AndrejRii/FireFighterCar/Documentation/Pictures/IMG_20231127_212735.jpg

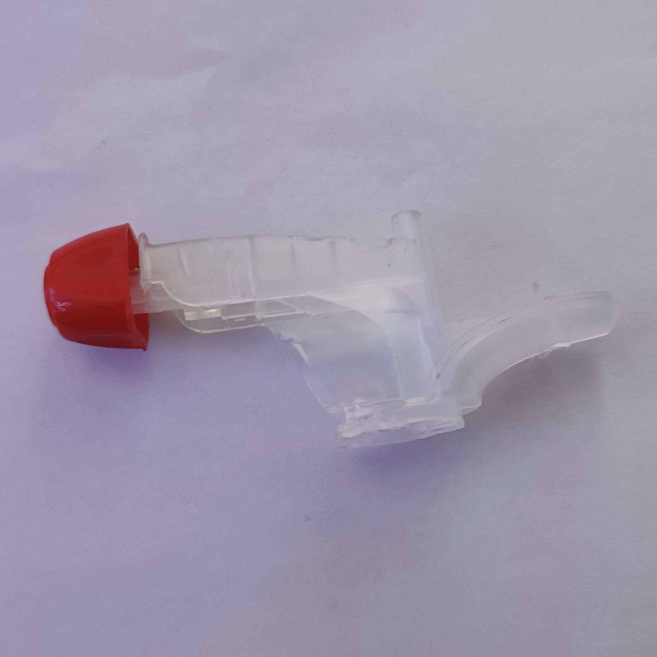
Documentation/Pictures/IMG_20231127_212735.jpg
