AndrejRii/FireFighterCar/Documentation/Pictures/IMG_20231127_210846.jpg

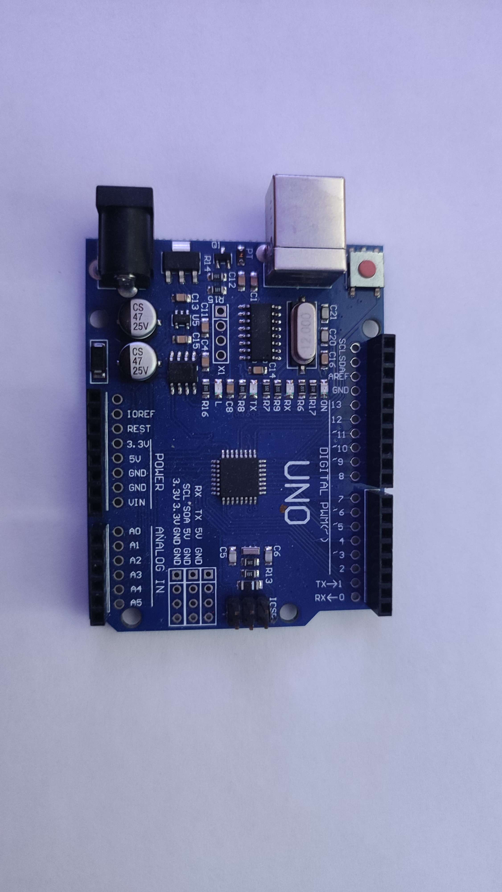
Documentation/Pictures/IMG_20231127_210846.jpg
