AndrejRii/FireFighterCar/Documentation/Pictures/IMG_20231127_210959.jpg

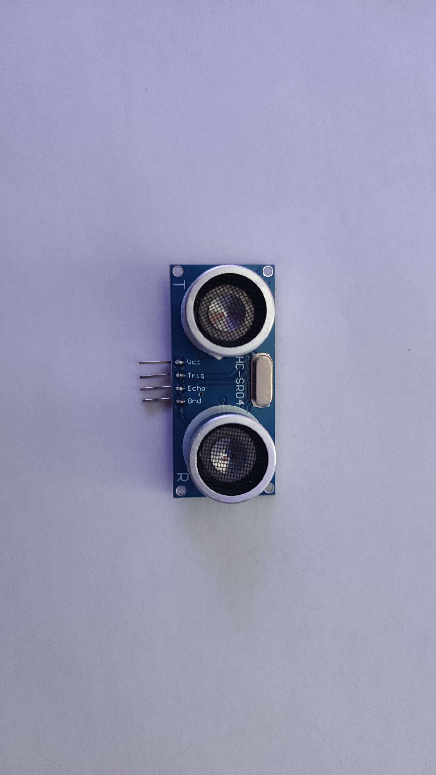
Documentation/Pictures/IMG_20231127_210959.jpg
