AndrejRii/FireFighterCar/Documentation/Pictures/IMG_20231127_212211.jpg

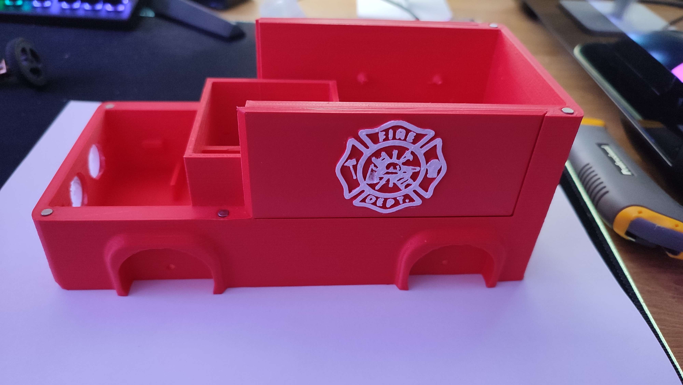
Documentation/Pictures/IMG_20231127_212211.jpg
