AndrejRii/FireFighterCar/Documentation/Pictures/IMG_20231127_212419.jpg

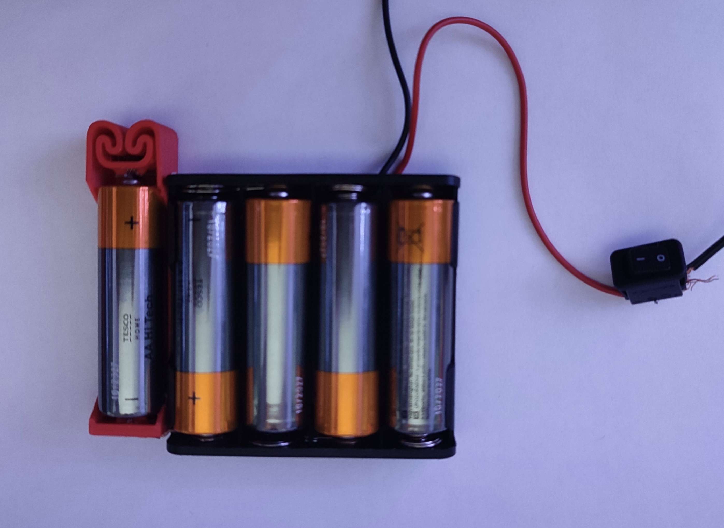
Documentation/Pictures/IMG_20231127_212419.jpg
