AndrejRii/FireFighterCar/Documentation/Pictures/IMG_20231127_212441.jpg

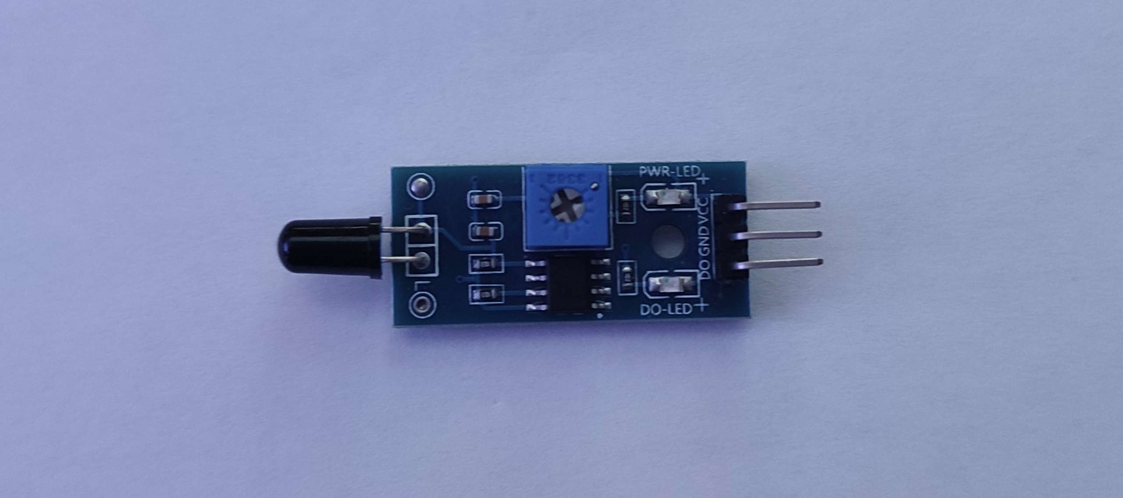
Documentation/Pictures/IMG_20231127_212441.jpg
