AndrejRii/FireFighterCar/Documentation/Pictures/IMG_20231127_212504.jpg

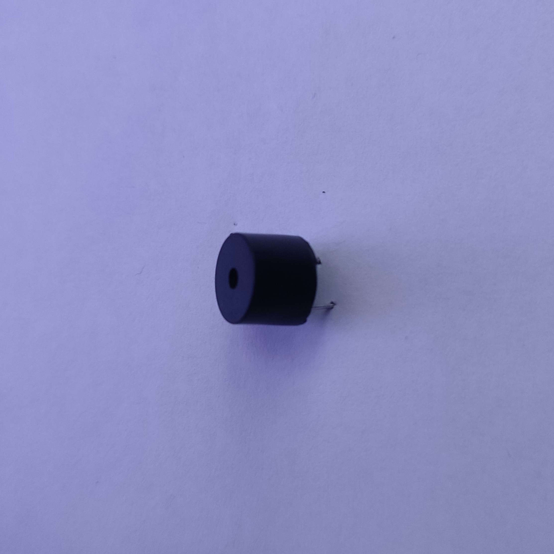
Documentation/Pictures/IMG_20231127_212504.jpg
